WOBIK497/pv-einstrahlungssensor/Einstrahlungssensor-Gehäuse/Bilder/deckel-unten-klein.jpg

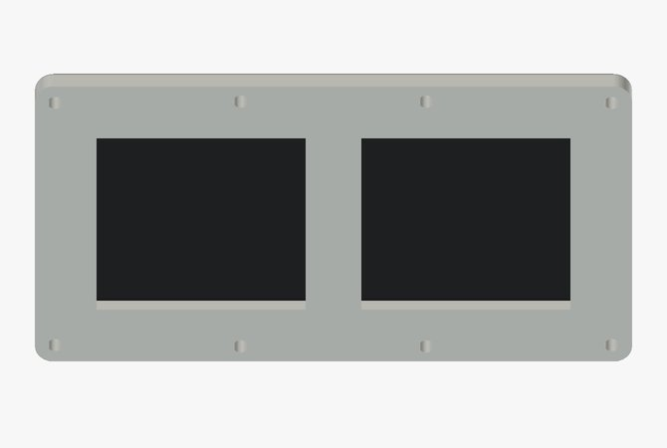
Einstrahlungssensor-Gehäuse/Bilder/deckel-unten-klein.jpg
