WOBIK497/pv-einstrahlungssensor/Einstrahlungssensor-Gehäuse/Bilder/deckel.jpg

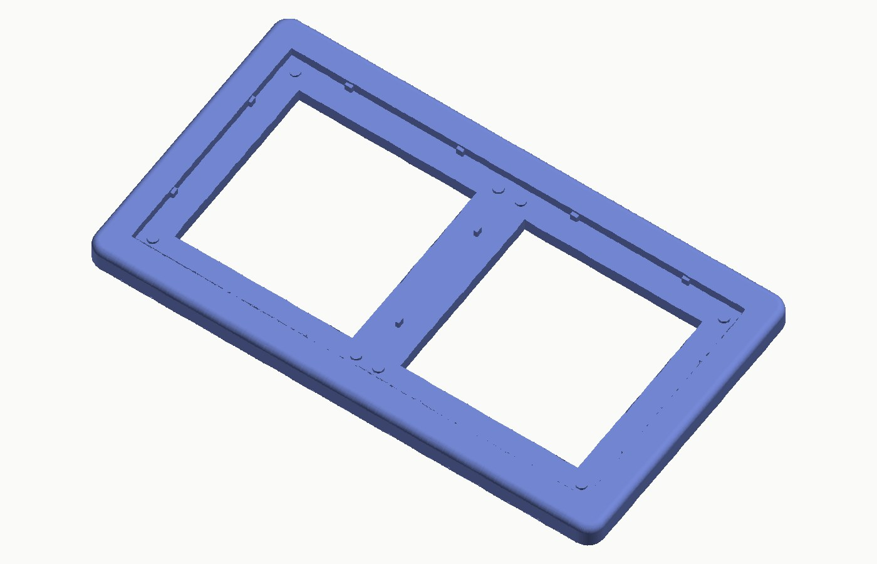
Einstrahlungssensor-Gehäuse/Bilder/deckel.jpg
