WOBIK497/pv-einstrahlungssensor/Einstrahlungssensor-Gehäuse/Bilder/kondensator-klein.jpg

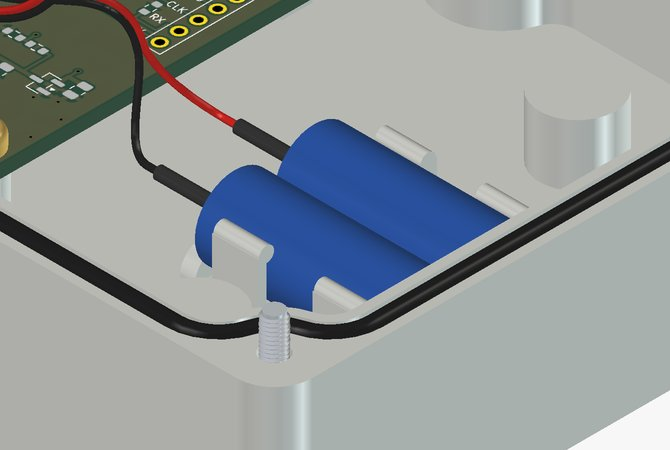
Einstrahlungssensor-Gehäuse/Bilder/kondensator-klein.jpg
