WOBIK497/pv-einstrahlungssensor/Einstrahlungssensor-Gehäuse/Bilder/unterseite-klein.jpg

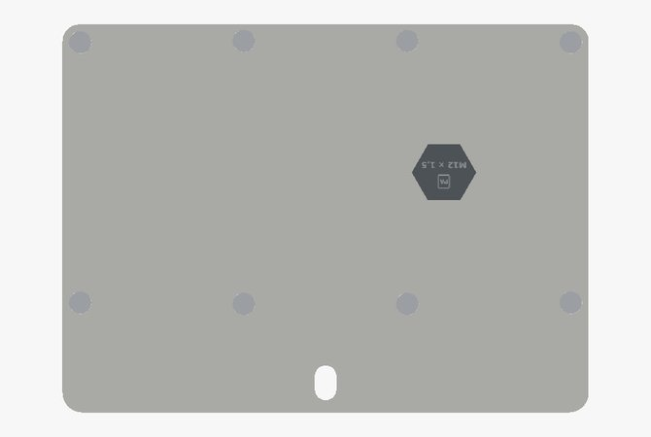
Einstrahlungssensor-Gehäuse/Bilder/unterseite-klein.jpg
