WOBIK497/pv-einstrahlungssensor/Einstrahlungssensor-Platine/Bilder/oben.png

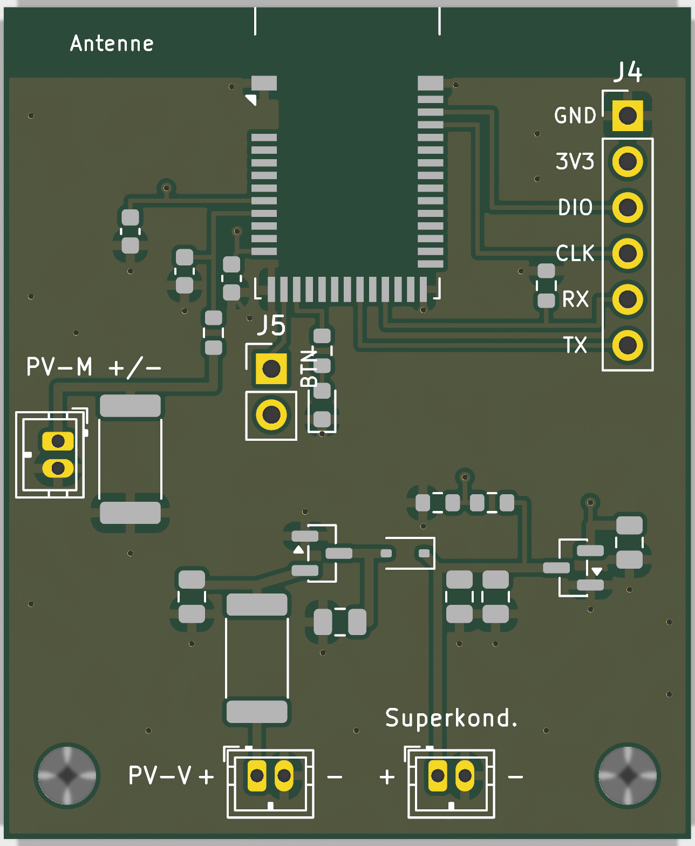
Einstrahlungssensor-Platine/Bilder/oben.png
