WOBIK497/pv-einstrahlungssensor/Einstrahlungssensor-Platine/Bilder/unten.png

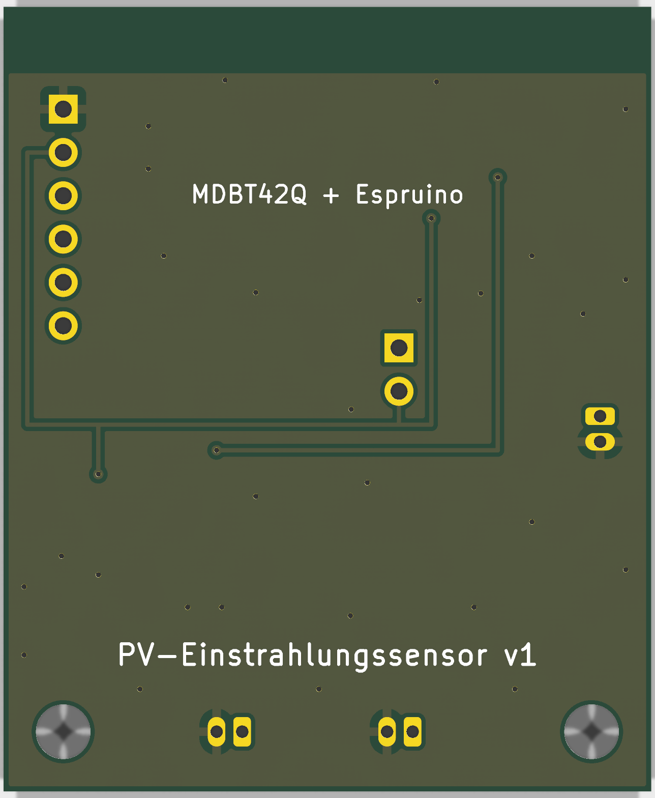
Einstrahlungssensor-Platine/Bilder/unten.png
