WOBIK497/pv-einstrahlungssensor/Einstrahlungssensor-Platine/jlcpcb-bom.csv

Comment | Designator | Footprint | LCSC Part #
10uF 25V | C1,C2,C6 | C_0805_2012Metric | C15850
22uF 25V | C3,C4 | C_0805_2012Metric | C45783
100nF | C7,C8,C9 | C_0603_1608Metric | C14663
B5819WS | D1 | D_SOD-323 | C7420331
LED rot | D2 | LED_0603_1608Metric | C2286
10R 1% 2W | R1,R2 | R_2512_6332Metric | C414890
10k | R3 | R_0603_1608Metric | C25804
1M | R4,R5,R7 | R_0603_1608Metric | C22935
1k | R6 | R_0603_1608Metric | C21190
HT7550-1 | U1 | SOT-23 | C5379082
XC6206P332MR | U2 | SOT-23 | C5446
