WOBIK497/pv-einstrahlungssensor/Einstrahlungssensor-Gehäuse/gehaeuse-unterteil.step

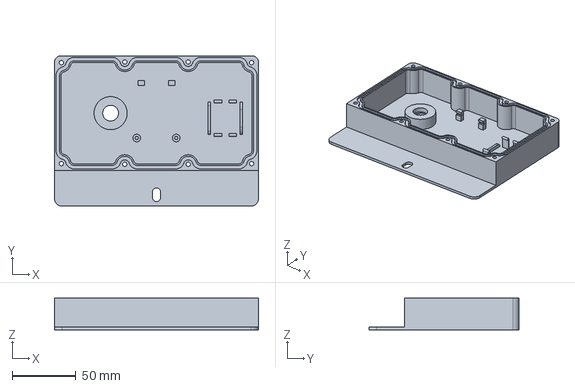
[picture p16: CAD file, 2026-11-14]
Einstrahlungssensor-Gehäuse/gehaeuse-unterteil.step
160.0 x 118.0 x 25.0 mm
