WOBIK497/pv-einstrahlungssensor/Einstrahlungssensor-Gehäuse/gehaeuse-deckel.step

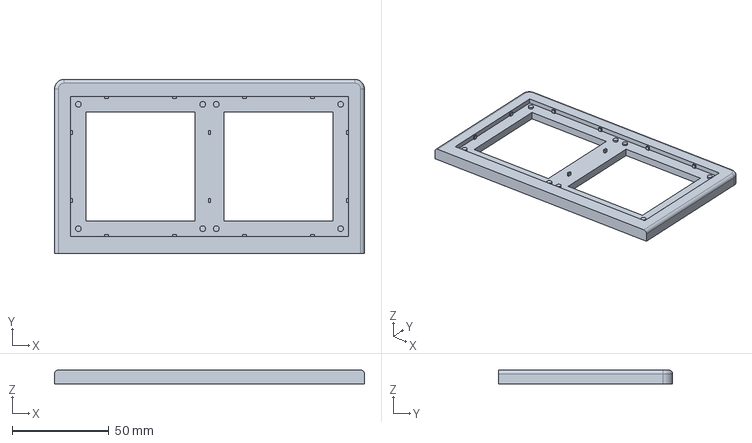
[picture p17: CAD file, 2026-11-14]
Einstrahlungssensor-Gehäuse/gehaeuse-deckel.step
160.0 x 90.0 x 7.20 mm
