WOBIK497/pv-einstrahlungssensor/Einstrahlungssensor-Gehäuse/Gehäuse mit Einbauteilen geschlossen.FCStd

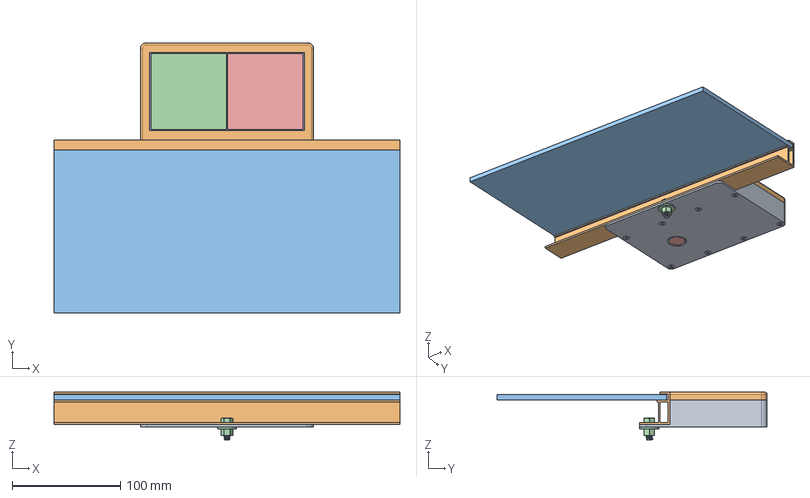
[picture p18: CAD file, 2026-11-11]
Einstrahlungssensor-Gehäuse/Gehäuse mit Einbauteilen geschlossen.FCStd
320.0 x 250.0 x 44.0 mm
Unterteil
Deckel
Solarmodule
Modul1_Bild
Modul2_Bild
Kleber
Dichtring
Kondensator
Kondensatordraehte
Druckausgleich
Druckausgleich_Membran
Gegenmutter
Druckausgleich_Bild
Deckelschrauben
Platinenschrauben
Platine
Platinenbild
Funkmodul
Funkmodul_Schirm
Funkmodul_Aufdruck
Funkmodul_Antenne
Buchsen
Buchsen_Kontakte
Stecker
Schrumpfschlauch
Rahmen
Paneelglas
Halterschrauben
Gewindeeinsaetze
Druckausgleich_Dichtring
