WOBIK497/pv-einstrahlungssensor/Einstrahlungssensor-Gehäuse/Gehäuse mit Einbauteilen offen.FCStd

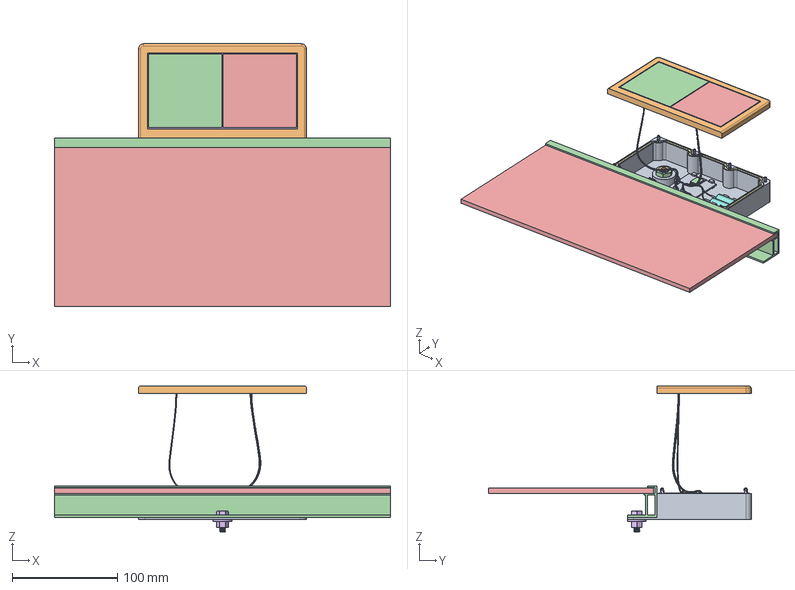
[picture p19: CAD file, 2026-11-11]
Einstrahlungssensor-Gehäuse/Gehäuse mit Einbauteilen offen.FCStd
320.0 x 250.0 x 139.0 mm
Unterteil
Deckel
Solarmodule
Modul1_Bild
Modul2_Bild
Kleber
Dichtring
Kondensator
Kondensatordraehte
Druckausgleich
Druckausgleich_Membran
Gegenmutter
Druckausgleich_Bild
Deckelschrauben
Platinenschrauben
Platine
Platinenbild
Funkmodul
Funkmodul_Schirm
Funkmodul_Aufdruck
Funkmodul_Antenne
Buchsen
Buchsen_Kontakte
Stecker
Litze_rot
Litze_schwarz
Schrumpfschlauch
Rahmen
Paneelglas
Halterschrauben
Gewindeeinsaetze
Druckausgleich_Dichtring
