WOBIK497/pv-einstrahlungssensor/Einstrahlungssensor-Gehäuse/Gehäuse mit Einbauteilen.FCStd

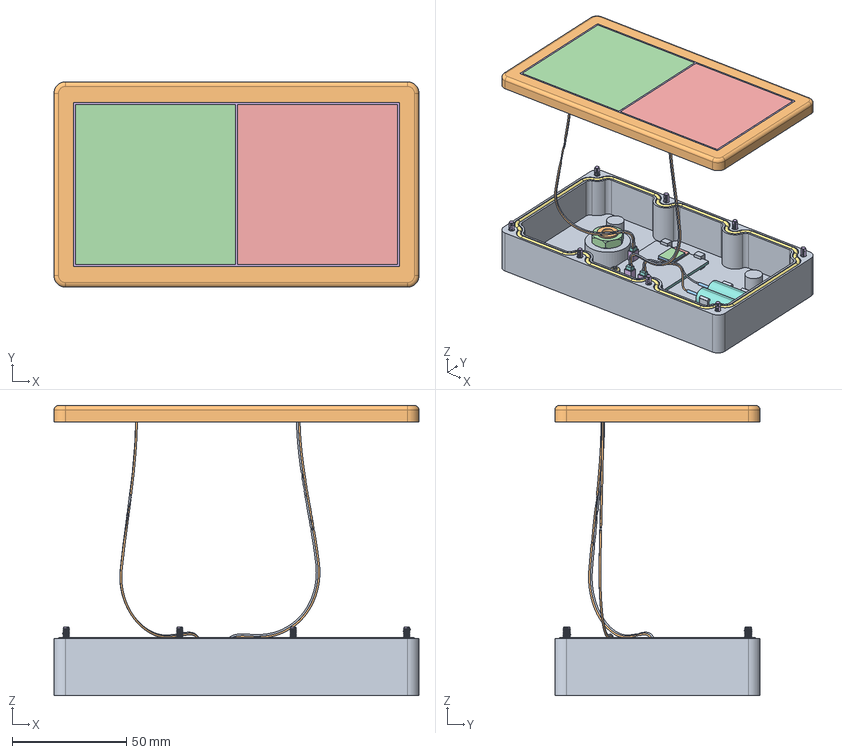
[picture p20: CAD file, 2026-11-09]
Einstrahlungssensor-Gehäuse/Gehäuse mit Einbauteilen.FCStd
160.0 x 90.0 x 127.2 mm
Unterteil
Deckel
Solarmodule
Modul1_Bild
Modul2_Bild
Kleber
Dichtring
Kondensator
Kondensatordraehte
Druckausgleich
Druckausgleich_Membran
Gegenmutter
Druckausgleich_Bild
Deckelschrauben
Platinenschrauben
Platine
Platinenbild
Funkmodul
Funkmodul_Schirm
Funkmodul_Aufdruck
Funkmodul_Antenne
Buchsen
Buchsen_Kontakte
Stecker
Litze_rot
Litze_schwarz
Schrumpfschlauch
