WOBIK497/pv-einstrahlungssensor/(list of files, cad)

Other CAD files:
Einstrahlungssensor-Gehäuse/gehaeuse-deckel.stl
Einstrahlungssensor-Gehäuse/gehaeuse-unterteil.stl
