WOBIK497/pv-einstrahlungssensor/Einstrahlungssensor-Platine/einstrahlungssensor.kicad_pcb

## KiCad design Einstrahlungssensor-Platine/einstrahlungssensor.kicad_pcb (2026-11-09)

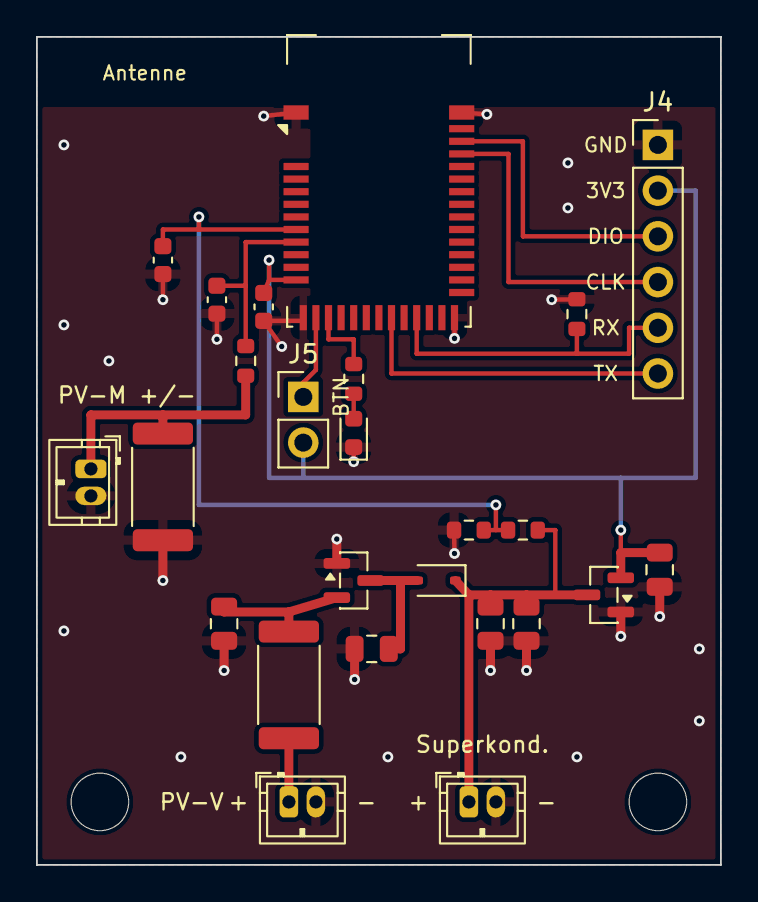
[picture p21: board einstrahlungssensor.kicad_pcb from above]

Board: 2 copper layers, 38.0 x 46.0 mm, 27 parts (0 on the bottom side), 16 nets.

Parts:
C1, C2, C6: 10uF 25V; C_0805_2012Metric
C3, C4: 22uF 25V; C_0805_2012Metric
C7, C8, C9: 100nF; C_0603_1608Metric
D1: B5819WS; D_SOD-323
D2: LED rot; LED_0603_1608Metric
H1, H2: M3; MountingHole_3.2mm_M3
J1, J2, J3: HC-ZH1.5-2A; JST_ZH_B2B-ZR_1x02_P1.50mm_Vertical
J4: Debug; PinHeader_1x06_P2.54mm_Vertical
J5: BTN; PinHeader_1x02_P2.54mm_Vertical
R1, R2: 10R 1% 2W; R_2512_6332Metric
R3: 10k; R_0603_1608Metric
R4, R5, R7: 1M; R_0603_1608Metric
R6: 1k; R_0603_1608Metric
U1: HT7550-1; SOT-23
U2: XC6206P332MR; SOT-23
U3: MDBT42Q (Espruino); Raytac_MDBT42Q

Connections:
+3V3: C6.2, C7.2, J4.2, J5.2, U2.2, U3.11
+5V: C2.2, D1.2, U1.3
BTN: J5.1, U3.13
DIV: C9.2, R4.1, R5.2, U3.7
GND: C1.1, C2.1, C3.1, C4.1, C6.1, C7.1, C8.1, C9.1, D2.1, J1.2, J2.2, J3.2, J4.1, R1.1, R5.1, R7.2, U1.1, U2.1, U3.1, U3.12, U3.24, U3.39
LEDA: D2.2, R6.1
LEDSIG: R6.2, U3.14
PV_M: J2.1, R1.2, R3.1
PV_R: C1.2, R2.2, U1.2
PV_V: J1.1, R2.1
RX: J4.5, R7.1, U3.21
SENSE: C8.2, R3.2, U3.8
SWDCLK: J4.4, U3.36
SWDIO: J4.3, U3.37
TX: J4.6, U3.19
VCAP: C3.2, C4.2, D1.1, J3.1, R4.2, U2.3
