WOBIK497/pv-einstrahlungssensor/(commit log)

2026-11-09 PV-Einstrahlungssensor: Platine, Gehäuse, Firmware und Dokumentation
    Kabelloser, batteriefreier Einstrahlungssensor für PV-Anlagen:
    ETFE-Solarmodul auf 10-Ω-Shunt als Messzelle, zweites Modul mit
    Superkondensator als Versorgung, MDBT42Q mit Espruino sendet per BTHome.
    - KiCad-9-Platine per Skript, Fertigungsdaten für JLCPCB
    - parametrisches FreeCAD-Gehäuse mit O-Ring und Druckausgleich
    - Espruino-Programm und Anleitung für Home Assistant
    - Lizenzen: CERN-OHL-S-2.0 (Hardware), MIT (Software)
    [Gehäuse mit Einbauteilen geschlossen.FCStd, Gehäuse mit Einbauteilen offen.FCStd, Gehäuse mit Einbauteilen.FCStd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]
2026-11-11 Rahmenmaße: Flanschdicke 1,7 mm aus der Datenblattzeichnung
    Die Flanschdicke ist aus der maßstabsgetreuen Profilzeichnung im Datenblatt
    ausgemessen (vorher 2,0 mm angenommen); M6 × 16 bleibt passend. Kommentare
    zur Herkunft der Rahmenmaße richtiggestellt: Lage des Montagelochs aus
    (1134 − 1096) / 2, Rahmenhöhe am Paneel mit 29,9 mm nachgemessen.
2026-11-11 README: Abschnitt „Andere Funkwege“
    Vergleich von Bluetooth LE, Zigbee, WLAN sowie GFSK und LoRa auf
    868 MHz für größere Dachanlagen ohne Bluetooth-Empfänger in der Nähe:
    Reichweite, Verbrauch gemessen an der Solarversorgung, Empfänger,
    Vor- und Nachteile. Der Sensor selbst bleibt bei BTHome.
2026-11-11 Baugruppe: Texturen der Bildflächen in den FCStd-Dateien
    FreeCAD 1.1 speichert Bilder im Material von Part-Objekten, zeichnet sie
    aber nicht. Ein Hilfsobjekt „Texturen“ trägt die Bilder eingebettet und
    legt sie über pv_textur.py beim Öffnen auf (Module, Platine, Funkmodul,
    Druckausgleich). README beschreibt die Baugruppen-Dateien.
    [Gehäuse mit Einbauteilen geschlossen.FCStd, Gehäuse mit Einbauteilen offen.FCStd]
2026-11-11 Baugruppe und Live-Ansicht: Kanten 1 px statt 2 px
    Linienbreite in beiden Baugruppen-Dateien auf 1 px gesetzt; die
    Live-Ansicht setzt sie nach jedem Neubau über LINIENBREITE.
    [Gehäuse mit Einbauteilen geschlossen.FCStd, Gehäuse mit Einbauteilen offen.FCStd]
2026-11-12 README: JLCPCB-Bestellung, ZH-Buchsen getrennt, Heizplatte
    - Bestellschritte nach der echten Bestellung: LeadFree HASL, Economic,
    Confirm Parts Placement, 11 Positionen, Lage von U1/U2, 72-h-Freigabe
    - ZH-Buchsen J1–J3 getrennt kaufen: JLCPCB verschickt keine losen Teile
    - Werkzeuglöcher von JLCPCB und Einfuhrabgaben je Versandart
    - Funkmodul alternativ per Heizplatte mit Sn42Bi58-Paste auflöten
    - Einkaufsliste: tatsächlicher JLCPCB-Preis, ZH-Set statt Einzelteilen
2026-11-12 README: Funkmodul ohne Firmware von TME, Espruino per Pico aufspielen
    - Funkmodul: Raytac MDBT42Q-512KV2 ohne Firmware (z. B. TME) statt des
    Espruino-Shops, der das nackte Modul nicht mehr führt; Warnung vor dem
    MDBT42Q-PAT (nRF52810)
    - Neuer Abschnitt: Espruino einmalig per SWD über J4 aufspielen, mit
    Raspberry Pi Pico als debugprobe und OpenOCD (nrf52_recover, program)
    - J4 dient jetzt dem Aufspielen; Stiftleiste und Pico in der Einkaufsliste
2026-11-14 Gehäuse: ASA statt PETG, gemessene Maße von Modulen, Kondensator und Druckausgleich
    - Material ASA (schwarz), Festigkeit/Dehnung als Parameter; Klammerarme 1,0 mm, Rastnase 25°
    - Module 70,2 × 70,2 × 1,8 mm, Kondensator 2 Zellen Ø 12,8 × 23 mm
    - Druckausgleich: Kopf SW 16,8 × 8,2, Sechskantsitz 3 mm (Belüftungsschlitze frei), Mutter 5,12 mm
    - STL/STEP neu, README nachgezogen
    [gehaeuse-deckel.step, gehaeuse-deckel.stl, gehaeuse-unterteil.step, gehaeuse-unterteil.stl]
